jvanderberg/hw140-teardown/schematic.png

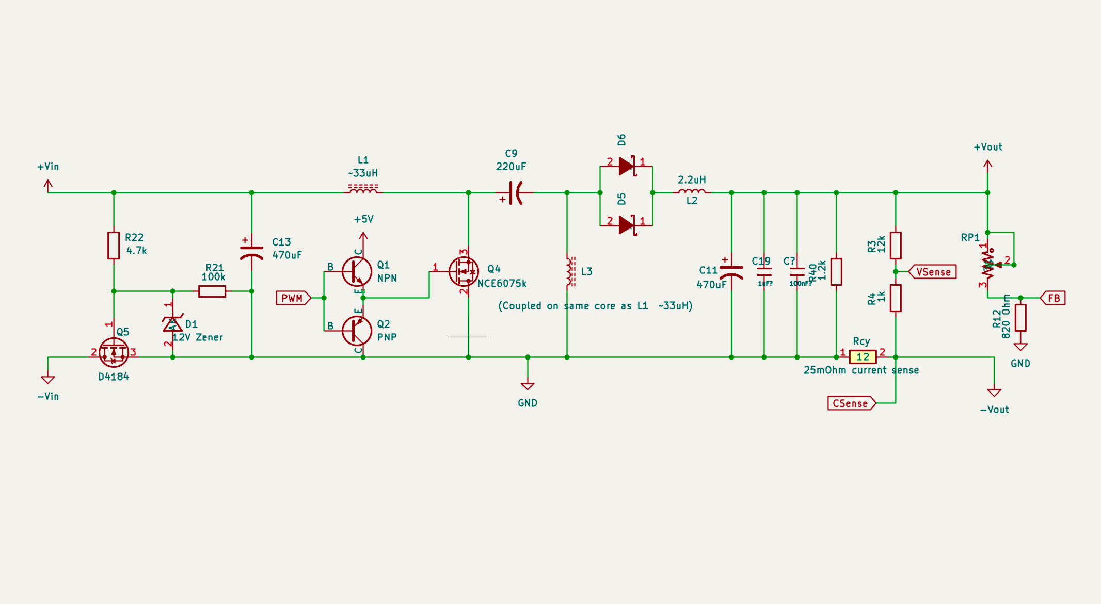
schematic.png
