jvanderberg/hw140-teardown/hw140.kicad_sch

## KiCad design hw140.kicad_sch (2026-02-11)

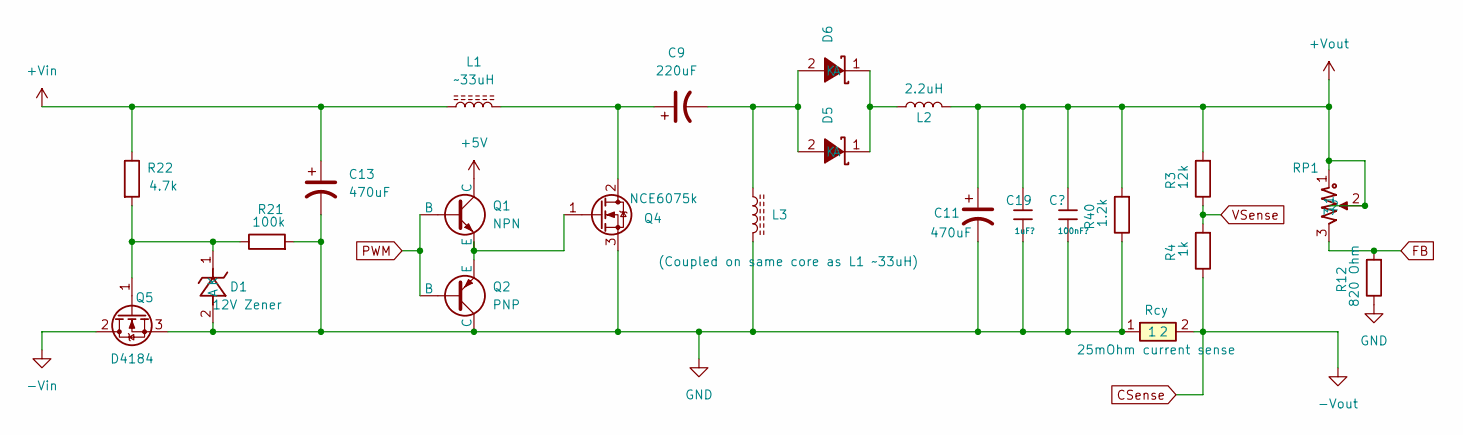
[picture p3: schematic hw140.kicad_sch]

Parts:
C9: 220uF
C11, C13: 470uF
C19: 1uF?; C_1206; Voltage Rated 50V; Tolerance ±10%; Part CL31B105KBHNNNE; LCSC C1848
D1: 12V Zener; ZMM12_C707203; Manufacturer Part ZMM12; LCSC C707203
D5, D6: SS56_C123947; Manufacturer Part SS56; LCSC C123947
L1: ~33uH
L2: 2.2uH
L3: (Coupled on same core as L1 ~33uH)
Q1: NPN
Q2: PNP
Q4: NCE6075k; TO-252-2
Q5: D4184; TO-252-2
R3: 12k
R4: 1k
R12: 820 Ohm
R21: 100k
R22: 4.7k
R40: 1.2k
RP1: 3266W-1-503LF; Manufacturer Part 3266W-1-503LF; LCSC C780226
Rcy: 25mOhm current sense; JER2512F3R025; Manufacturer Part JER2512F3R025; LCSC C46634463

Connections:
+5V: Q1.1 (C)
+Vin: C13.1, L1.1, R22.1
+Vout: C11.1, C19.1, L2.2, R3.2, R40.2, RP1.1, RP1.2
-Vin: Q5.2 (D)
-Vout: R4.1, Rcy.2
FB: R12.2, RP1.3
GND: C11.2, C13.2, C19.2, D1.2 (A), L3.2, Q2.1 (C), Q4.3 (S), Q5.3 (S), R12.1, R21.2, R40.1, Rcy.1
unnamed: C9.1, L1.2, Q4.2 (D)
unnamed: C9.2, D5.2 (A), D6.2 (A), L3.1
unnamed: D1.1 (K), Q5.1 (G), R21.1, R22.2
unnamed: D5.1 (K), D6.1 (K), L2.1
unnamed: Q1.3 (E), Q2.3 (E), Q4.1 (G)
PWM: Q1.2 (B), Q2.2 (B)
VSense: R3.1, R4.2
