jvanderberg/hw140-teardown/(commit log)

2026-02-10 Initial commit: HW-140 reverse-engineered schematic and notes
    KiCad schematic of the HW-140 SEPIC buck-boost module power stage,
    traced from the PCB during teardown. Includes component symbol library
    and README with datasheet links.
    [hw140.kicad_sch]
2026-02-10 Remove 3D models, footprints, and footprint lib table
    These aren't needed for viewing the schematic.
2026-02-10 Add schematic screenshot to README
2026-02-11 Fix reversed MOSFET
    [hw140.kicad_sch]
